rustyRaccoon/DiffProbe/README.md

# DiffProbe
 High Voltage differential probe for a scope running on 5V USB
