rustyRaccoon/DiffProbe/Simulations/DiffProbe_-20dB_bode.pdf

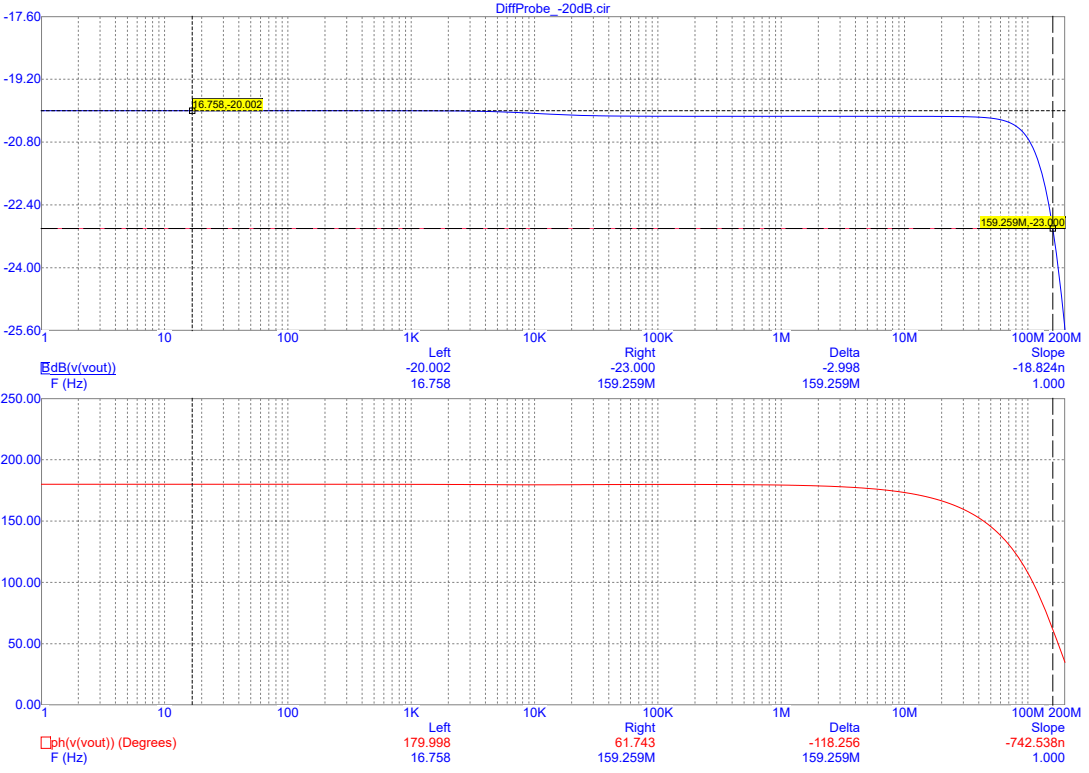
[picture p1: page 1]
BdB(v(vout)) F (Hz); DiffProbe_-20dB.cir; Left; Right; Delta; Slope

ph(v(vout)) (Degrees)
