rustyRaccoon/DiffProbe/Simulations/DiffProbe_-20dB.cir

[Main]
FileType=CIR
Version=12.00
Program=Micro-Cap
Component Version=10.00
Shape Version=11.00
Screen=3072,1728
MCAPVersion=12.2.0.5
Key ID=Demo
NLCnt=238
TXCnt=29

[shapedef]
Name=Battery
Line=0,0,22,0
Line=22,-3,22,3
Line=26,-7,26,7
Line=26,0,48,0
Current=32,8,16,8

[shapedef]
Name=Capacitor
Line=0,0,22,0
Line=22,-8,22,8
Line=26,-8,26,8
Line=26,0,48,0
Current=32,12,16,12

[shapedef]
Name=Diode
Root="Diode.root",0,0,0

[shapedef]
Name=Diode.root
Line=0,0,20,0
Line=28,0,48,0
Rectangle=18,-8,20,8
PolyClosed=3
PolyLine=20,0
PolyLine=28,-8
PolyLine=28,8
Current=32,16,16,16

[shapedef]
Name=DPMOS
Root="Mos2.root",0,0,0
Line=14,0,24,0
PolyClosed=3
PolyLine=17,-3
PolyLine=17,3
PolyLine=20,0

[shapedef]
Name=Ferrite Bead
Arc=26,-8,32,8 , 29,9,29,-10
Line=48,0,32,0
Ellipse=20,-4,23,4
FColor=None
Ellipse=18,-8,25,8
FColor=None
Line=21,-8,29,-8
Line=29,8,21,8
Line=0,0,22,0

[shapedef]
Name=Ground
Line=0,0,12,0
Line=12,-8,12,8
Line=18,-4,18,4
Line=24,0,24,0

[shapedef]
Name=Minus.root
Line=-2,0,2,0

[shapedef]
Name=Mos2.root
Line=0,8,10,8
Line=10,-8,10,8
Line=14,-11,14,-5
Line=14,-3,14,3
Line=14,5,14,11
Line=14,-8,24,-8
Line=14,8,24,8
Line=24,0,24,24
Line=24,-8,24,-24
Current=32,-24,32,-16
Current=32,24,32,16
Current=0,0,8,0

[shapedef]
Name=Opamp5
Root="Opamp.root",0,0,0
Root="Plus.root",25,-4,0
Root="Minus.root",25,52,0
Line=32,56,32,34
Line=32,-8,32,13

[shapedef]
Name=Opamp.root
Line=0,48,6,48
Line=0,0,5,0
Line=6,-4,6,52
Line=6,-4,48,24
Line=6,52,48,24
Line=48,24,72,24
Line=10,12,14,12
Line=12,10,12,14
Line=10,36,14,36
Line=4,0,6,0

[shapedef]
Name=Plus.root
Line=-2,0,2,0
Line=0,-2,0,2

[shapedef]
Name=Pot
Line=0,0,12,0
Line=12,0,14,-4
Line=14,-4,18,4
Line=18,4,22,-4
Line=22,-4,26,4
Line=26,4,30,-4
Line=30,-4,34,4
Line=34,4,36,0
Line=36,0,48,0
PolyClosed=4
PolyLine=24,4
PolyLine=24,4
PolyLine=22,8
PolyLine=26,8
Line=24,8,24,16

[shapedef]
Name=Resistor
PolyOpen=12
PolyLine=0,0
PolyLine=0,0
PolyLine=12,0
PolyLine=14,-4
PolyLine=18,4
PolyLine=22,-4
PolyLine=26,4
PolyLine=30,-4
PolyLine=34,4
PolyLine=36,0
PolyLine=48,0
PolyLine=48,0
Current=32,8,16,8

[shapedef]
Name=Sparkgap
Ellipse=0,-8,32,24
FColor=None
Line=16,-16,16,0
Line=16,16,16,32
Rectangle=8,-2,24,0
Rectangle=8,16,24,18

[shapedef]
Name=SPICE_V
Root="Vsource.root",0,0,0

[shapedef]
Name=Vsource.root
Line=0,0,12,0
Line=36,0,48,0
Ellipse=12,-12,36,12
FColor=None
Line=7,5,7,9
Root="Plus.root",41,7,0
Current=32,16,16,16

[compdef]
Name=Capacitor
Definition=Capacitor
Shape=Capacitor
Mask=7425
Used=77
memo=Capacitor
Label Offset=16,12,12,12
PinCnt=2
Pin="Plus",6,0,-3,-5
Pin="Minus",0,0,-14,-5

[compdef]
Name=Resistor
Definition=Resistor
Shape=Resistor
Mask=7937
Used=289
memo=Resistor
Label Offset=18,6,8,11
PinCnt=2
Pin="Plus",6,0,-10,-4
Pin="Minus",0,0,-14,-4

[compdef]
Name=Pot
Definition=Macro
Shape=Pot
Mask=5632
Used=7
memo=Potentiometer Macro
Label Offset=32,4,9,11
PinCnt=3
Pin="PINA",a,0,0,-13,-5
Pin="PINB",a,3,2,6,5
Pin="PINC",a,6,0,-12,-5

[compdef]
Name=Ground
Definition=Ground
Shape=Ground
Mask=257
Used=349
memo=Ground
Label Offset=0,0,0,0
PinCnt=1
Pin="PinA",0,0,-3,-7

[compdef]
Name=Voltage Source
Definition=VSpice
Shape=SPICE_V
Mask=4865
Used=48
memo=Voltage Source
Label Offset=19,13,15,13
PinCnt=2
Pin="Plus",6,0,-5,-6
Pin="Minus",0,0,-20,-6

[compdef]
Name=Battery
Definition=Battery
Shape=Battery
Mask=6913
Used=54
memo=Battery
Label Offset=19,7,10,13
PinCnt=2
Pin="Plus",6,0,-4,-5
Pin="Minus",0,0,-10,-5

[compdef]
Name=1N4148
Definition=Diode
Shape=Diode
Mask=4226
memo=Switching Diode Vr=100V If=200mA
Label Offset=18,10,12,12
PinCnt=2
Pin="Anode",6,0,-13,-8
Pin="Cathode",0,0,-27,-8

[compdef]
Name=LM7301_NS
Definition=Subckt
Shape=Opamp5
Mask=4224
memo=Low Power, 4MHz GBW, Rail-to-Rail Input-Output Opamp
Label Offset=51,34,-8,44
PinCnt=5
Pin="3",a,0,0,-3,-4
Pin="2",a,0,6,-3,18
Pin="4",a,4,-1,6,15
Pin="5",a,4,7,6,0
Pin="6",a,9,3,-3,-3

[compdef]
Name=Opamp
Definition=Opamp
Shape=Opamp5
Mask=4097
Used=4
memo=Opamp
Label Offset=44,29,-14,39
PinCnt=5
Pin="Plus input",0,0,-31,-7
Pin="Minus input",0,6,-33,20
Pin="VEE",4,7,3,-5
Pin="Output",9,3,-13,-4
Pin="VCC",4,-1,5,14

[compdef]
Name=DPMOS
Definition=PMOS
Shape=DPMOS
Mask=4096
memo=DPMOS
Label Offset=28,-11,-5,25
PinCnt=4
Pin="Drain",3,-3,8,5
Pin="Gate",0,1,-20,-3
Pin="Source",3,3,8,11
Pin="Body",3,3,8,0

[compdef]
Name=ILBB0805_320
Definition=Subckt
Shape=Ferrite Bead
Mask=4224
memo=Multilayer Ferrite Bead Z=32ohm Idc=600mA
Label Offset=21,11,9,10
PinCnt=2
Pin="1",a,0,0
Pin="2",a,6,0

[compdef]
Name=Sparkgap
Definition=Macro
Shape=Sparkgap
Mask=4096
memo=Sparkgap Macro
Link=http://www.spectrum-soft.com/news/winter99/sparkgap.shtm
Label Offset=35,-6,-14,32
PinCnt=2
Pin="Pin1",a,2,-2,5,8
Pin="Pin2",a,2,4,5,5

[Circuit]
Window Placement=2,3, -1,-1, -8,-31, 838,0,1674,842
Default Object=Color=#FF396B
Default Object Font=Height=-15,FStyle=0,Color=#000080,Name=Arial
Default Object Apply Border To Text=No
Default Object Apply Fill To Text=No
Default Object GridSnap=No
NodeVoltageFormat=3
CurrentFormat=3
PowerFormat=3
PathDelayFormat=3
WarningFormat=3
GridTextFormulaFormat=3
Window Placement in Transient Analysis=2,3, -1,-1, -8,-31, 0,242,949,655
Window Placement in AC Analysis=2,3, -1,-1, -8,-31, 0,0,949,655
Window Placement in DC Analysis=2,3, -1,-1, -8,-31, 0,0,1363,669
SpiceType=AMBIGUOUS
Title_Block_Border=None
Title_Block=False
Show Nodes=False
Show Voltages=True
Show Current=False
Show Power=False
Show Condition=False
Show Pin Connections=False
Show Connection Warnings=False
Show Cross=False
Show Attribute Text=True
Show Grid Text=True

[Object]
Object=Rectangle
CBorder=#000080
Px=1524,1386,2288,1684

[Object]
Object=Rectangle
CBorder=#000080
Px=1392,783,1917,1344

[Object]
Object=Rectangle
CBorder=#000080
Px=1964,766,2529,1286

[Comp]
Name=Capacitor
Px=1632,864
Rot=6

[Attr]
ON=-32,-40,PART
V=C1
Style=8192

[Attr]
ON=-34,-25,CAPACITANCE
V=12p
Style=8192

[Attr]
ON=0,44,MODEL
V=TOL

[Attr]
ON=0,0,PACKAGE
V

[Comp]
Name=Resistor
Px=1560,912

[Attr]
ON=18,6,PART
V=R1
Style=8192

[Attr]
ON=18,20,RESISTANCE
V=1.5Meg
Style=8192

[Attr]
ON=0,33,MODEL
V=TOL

[Attr]
ON=0,0,PACKAGE
V

[Comp]
Name=Capacitor
Px=1632,1296
Rot=2

[Attr]
ON=-33,26,PART
V=C5
Style=8192

[Attr]
ON=-36,8,CAPACITANCE
V=12p
Style=8192

[Attr]
ON=0,44,MODEL
V=TOL

[Attr]
ON=0,0,PACKAGE
V

[Comp]
Name=Resistor
Px=1560,1248
Rot=4

[Attr]
ON=18,-20,PART
V=R5
Style=8192

[Attr]
ON=18,-34,RESISTANCE
V=1.5Meg
Style=8192

[Attr]
ON=0,33,MODEL
V=TOL

[Attr]
ON=0,0,PACKAGE
V

[Comp]
Name=Resistor
Px=1632,960
Rot=1

[Attr]
ON=8,11,PART
V=R9
Style=8192

[Attr]
ON=8,25,RESISTANCE
V=100k
Style=8192

[Attr]
ON=0,33,MODEL
V=TOL

[Attr]
ON=0,0,PACKAGE
V

[Attr]
ON=0,11,COMBINATION
V=35.7K

[Comp]
Name=Resistor
Px=1632,1008
Rot=1

[Attr]
ON=8,11,PART
V=R10
Style=8192

[Attr]
ON=8,25,RESISTANCE
V=1k
Style=8192

[Attr]
ON=0,33,MODEL
V=TOL

[Attr]
ON=0,0,PACKAGE
V

[Attr]
ON=0,11,COMBINATION
V=3.01K

[Comp]
Name=Resistor
Px=1632,1200
Rot=5

[Attr]
ON=8,-25,PART
V=R11
Style=8192

[Attr]
ON=8,-39,RESISTANCE
V=100k
Style=8192

[Attr]
ON=0,33,MODEL
V=TOL

[Attr]
ON=0,0,PACKAGE
V

[Attr]
ON=0,11,COMBINATION
V=35.7K

[Comp]
Name=Resistor
Px=1632,1152
Rot=5

[Attr]
ON=8,-25,PART
V=R12
Style=8192

[Attr]
ON=8,-39,RESISTANCE
V=1k
Style=8192

[Attr]
ON=0,33,MODEL
V=TOL

[Attr]
ON=0,0,PACKAGE
V

[Attr]
ON=0,11,COMBINATION
V=3.01K

[Comp]
Name=Pot
Px=1632,1104
Rot=3

[Attr]
ON=-25,-25,PART
V=X1
Style=8192

[Attr]
ON=-30,-39,FILE
V=Pot

[Attr]
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
CurrentSection 3=0
Splitter.xs=0
Splitter.ys=0
TextQuad=4099
Scale=1
GridType=GraphPaper
GridUser=10
ShapeGroups="Main","Euro","Polarity","Main1","Main11","Electrolytic","GroundArrow","DeMorgan"
CalcRMS=False
CalcAVG=False
CalcPeak=False
CalcVoltage=True
DisplayMeasure=Last
ShareScales=True
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
