rustyRaccoon/DiffProbe/DiffProbe.kicad_pcb

## KiCad design DiffProbe.kicad_pcb (2023-03-25)

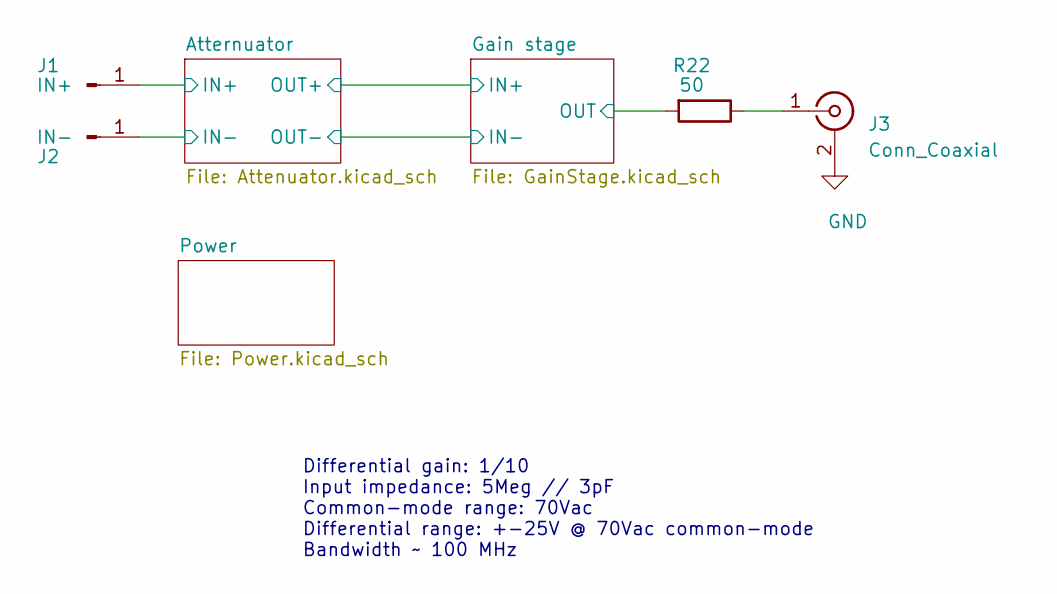
[picture p2: schematic DiffProbe.kicad_sch]

Parts:
J1: IN+; PinHeader_1x01_P2.54mm_Horizontal
J2: IN-; PinHeader_1x01_P2.54mm_Horizontal
J3: Conn_Coaxial; SMA_Samtec_SMA-J-P-X-ST-EM1_EdgeMount
R22: 50; R_0603_1608Metric

Connections:
/Atternuator/IN+: J1.1; also elsewhere on the board
/Atternuator/IN-: J2.1; also elsewhere on the board
/Gain stage/OUT: R22.2; also elsewhere on the board
GND: J3.2 (Ext); also elsewhere on the board
unnamed: J3.1 (In), R22.1

Notes on the sheet:
Differential gain: 1/10 Input impedance: 5Meg // 3pF Common-mode range: 70Vac Differential range: +-25V @ 70Vac common-mode Bandwidth ~ 100 MHz

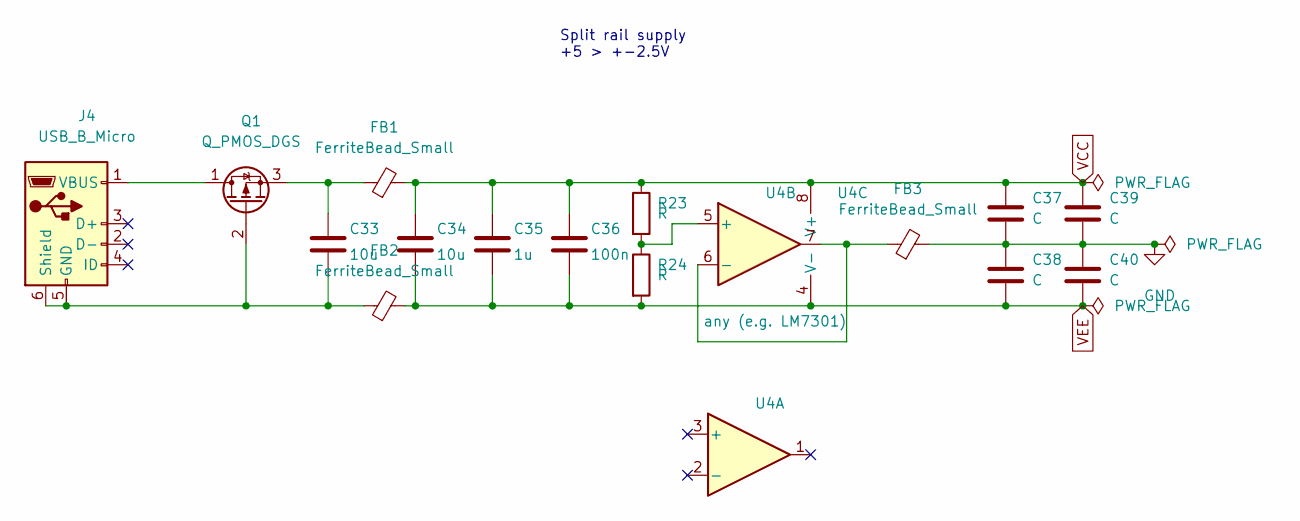
[picture p3: schematic Power.kicad_sch]

Parts:
C33, C34: 10u; C_0603_1608Metric
C35: 1u; C_0603_1608Metric
C36: 100n; C_0603_1608Metric
C37, C38, C39, C40: C; C_0603_1608Metric
FB1, FB2, FB3: FerriteBead_Small; L_0603_1608Metric
J4: USB_B_Micro; USB_Micro-AB_Molex_47590-0001
Q1: Q_PMOS_DGS; TSOT-23
R23, R24: R; R_0603_1608Metric
U4: any (e.g. LM7301); MSOP-8_3x3mm_P0.65mm

Connections:
GND: C37.2, C38.1, C39.2, C40.1, FB3.2; also elsewhere on the board
unnamed: C33.2, FB2.1, J4.5 (GND), J4.6 (Shield), Q1.2 (G)
unnamed: J4.1 (VBUS), Q1.1 (D)
unnamed: C33.1, FB1.1, Q1.3 (S)
unnamed: R23.2, R24.1, U4.5 (+)
unnamed: FB3.1, U4.6 (-), U4.7
VCC: C34.1, C35.1, C36.1, C37.1, C39.1, FB1.2, R23.1, U4.8 (V+); also elsewhere on the board
VEE: C34.2, C35.2, C36.2, C38.2, C40.2, FB2.2, R24.2, U4.4 (V-); also elsewhere on the board

Notes on the sheet:
Split rail supply +5 > +-2.5V

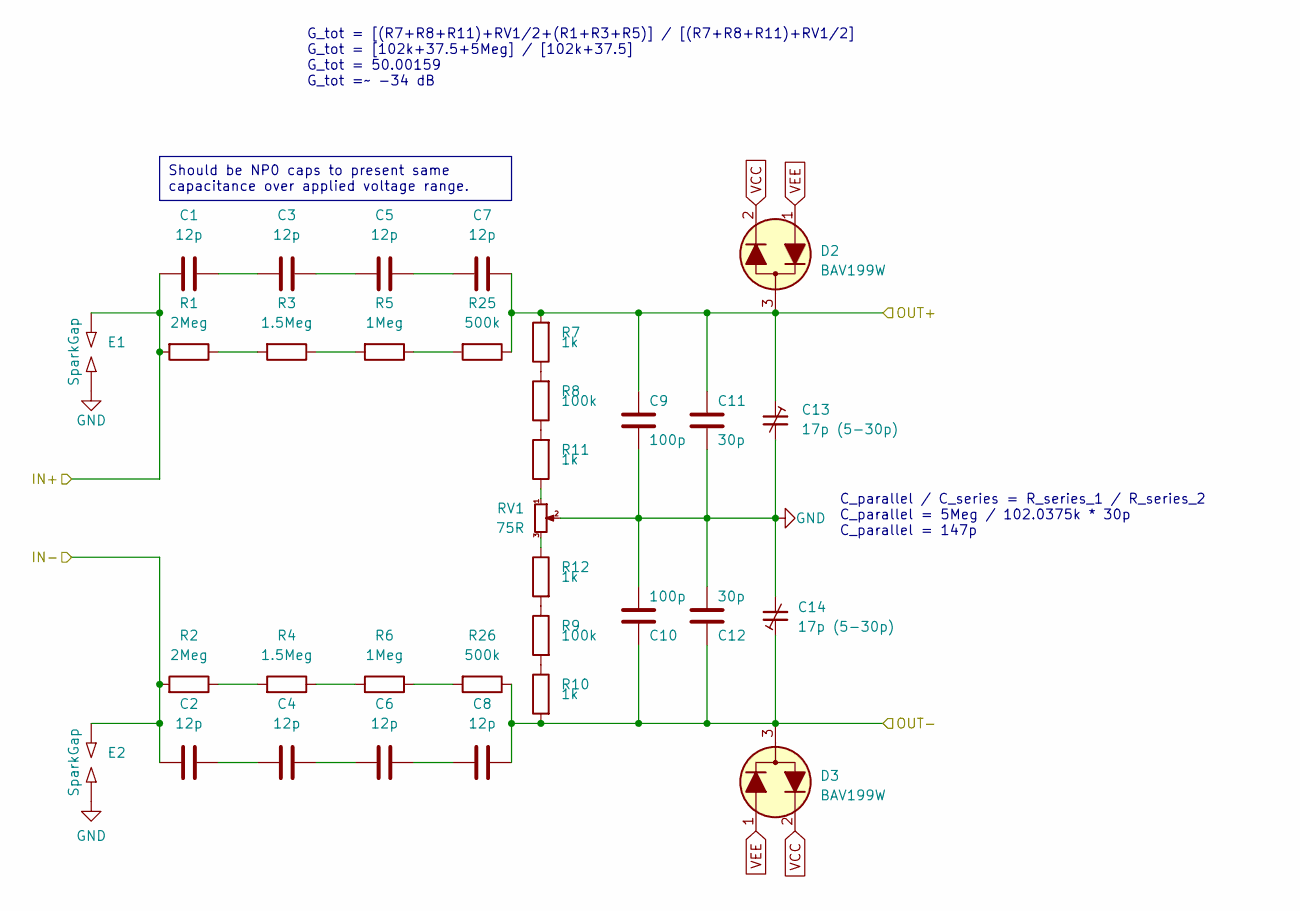
[picture p4: schematic Attenuator.kicad_sch]

Parts:
C1, C2, C3, C4, C5, C6, C7, C8: 12p; C_0603_1608Metric
C9, C10: 100p; C_0603_1608Metric
C11, C12: 30p; C_0603_1608Metric
C13, C14: 17p (5-30p); C_Trimmer_Murata_TZB4-A
D2, D3: BAV199W; SC-70
E1, E2: SparkGap; Spark_Gap_1.65x1.1
R1, R2: 2Meg; R_0603_1608Metric
R3, R4: 1.5Meg; R_0603_1608Metric
R5, R6: 1Meg; R_0603_1608Metric
R7, R10, R11, R12: 1k; R_0603_1608Metric
R8, R9: 100k; R_0603_1608Metric
R25, R26: 500k; R_0603_1608Metric
RV1: 75R; Potentiometer_Bourns_3214W_Vertical

Connections:
/Atternuator/IN+: C1.2, E1.1, R1.2; also elsewhere on the board
/Atternuator/IN-: C2.2, E2.1, R2.2; also elsewhere on the board
/Atternuator/OUT+: C7.1, C9.1, C11.1, C13.1, D2.3 (C), R7.2, R25.1; also elsewhere on the board
/Atternuator/OUT-: C8.1, C10.1, C12.1, C14.1, D3.3 (C), R10.2, R26.1; also elsewhere on the board
GND: C9.2, C10.2, C11.2, C12.2, C13.2, C14.2, E1.2, E2.2, RV1.2; also elsewhere on the board
unnamed: C1.1, C3.2
unnamed: C2.1, C4.2
unnamed: C3.1, C5.2
unnamed: C4.1, C6.2
unnamed: C5.1, C7.2
unnamed: C6.1, C8.2
unnamed: R1.1, R3.2
unnamed: R2.1, R4.2
unnamed: R3.1, R5.2
unnamed: R4.1, R6.2
unnamed: R7.1, R8.2
unnamed: R9.2, R10.1
unnamed: R11.1, RV1.1
unnamed: R8.1, R11.2
unnamed: R12.1, RV1.3
unnamed: R9.1, R12.2
unnamed: R5.1, R25.2
unnamed: R6.1, R26.2
VCC: D2.2 (K), D3.2 (K); also elsewhere on the board
VEE: D2.1 (A), D3.1 (A); also elsewhere on the board

Notes on the sheet:
Should be NP0 caps to present same capacitance over applied voltage range.
C_parallel / C_series = R_series_1 / R_series_2 C_parallel = 5Meg / 102.0375k * 30p C_parallel = 147p
G_tot = [(R7+R8+R11)+RV1/2+(R1+R3+R5)] / [(R7+R8+R11)+RV1/2] G_tot = [102k+37.5+5Meg] / [102k+37.5] G_tot = 50.00159 G_tot =~ -34 dB

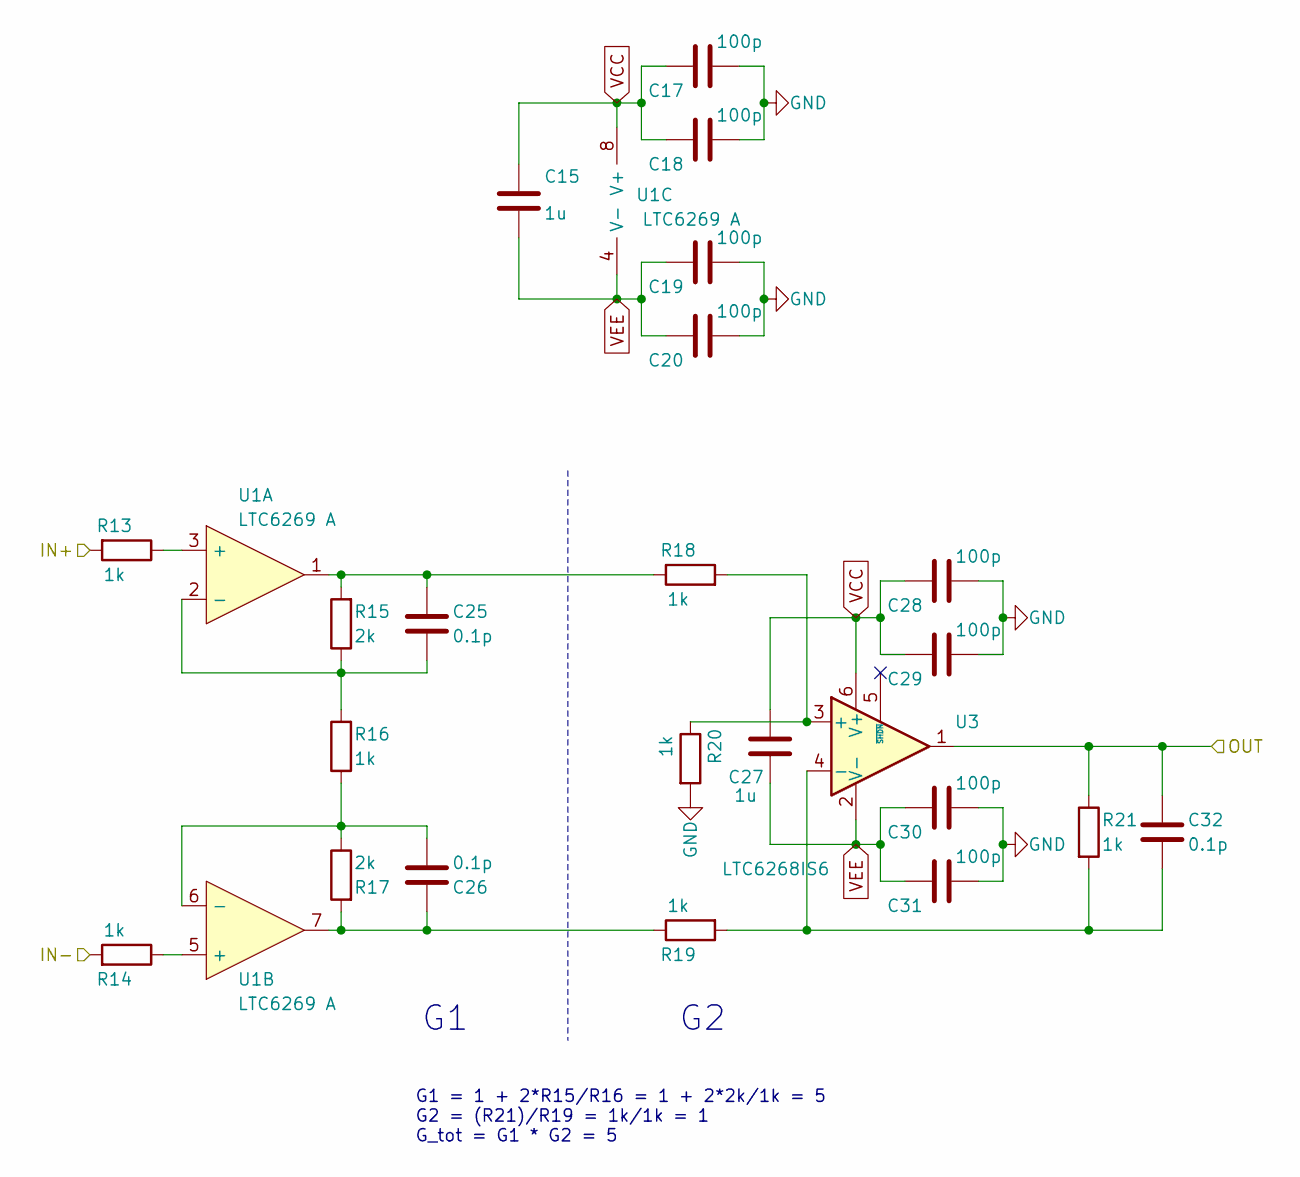
[picture p5: schematic GainStage.kicad_sch]

Parts:
C15, C27: 1u; C_0603_1608Metric
C17, C18, C19, C20, C28, C29, C30, C31: 100p; C_0603_1608Metric
C25, C26, C32: 0.1p; C_0603_1608Metric
R13, R14, R16, R18, R19, R20, R21: 1k; R_0603_1608Metric
R15, R17: 2k; R_0603_1608Metric
U1: LTC6269 A; MSOP-8-1EP_3x3mm_P0.65mm_EP1.68x1.88mm
U3: LTC6268IS6; TSOT-23-6

Connections:
/Atternuator/OUT+: R13.2; also elsewhere on the board
/Atternuator/OUT-: R14.2; also elsewhere on the board
/Gain stage/OUT: C32.2, R21.1, U3.1; also elsewhere on the board
GND: C17.1, C18.1, C19.1, C20.1, C28.1, C29.1, C30.1, C31.1, R20.2; also elsewhere on the board
unnamed: C25.1, R15.2, R18.1, U1.1
unnamed: C26.1, R17.2, R19.1, U1.7
unnamed: R13.1, U1.3 (+)
unnamed: C25.2, R15.1, R16.2, U1.2 (-)
unnamed: R14.1, U1.5 (+)
unnamed: C26.2, R16.1, R17.1, U1.6 (-)
unnamed: R18.2, R20.1, U3.3 (+)
unnamed: C32.1, R19.2, R21.2, U3.4 (-)
VCC: C15.1, C17.2, C18.2, C27.1, C28.2, C29.2, U1.8 (V+), U3.6 (V+); also elsewhere on the board
VEE: C15.2, C19.2, C20.2, C27.2, C30.2, C31.2, U1.4 (V-), U1.9 (V-), U3.2 (V-); also elsewhere on the board

Notes on the sheet:
G1 = 1 + 2*R15/R16 = 1 + 2*2k/1k = 5 G2 = (R21)/R19 = 1k/1k = 1 G_tot = G1 * G2 = 5

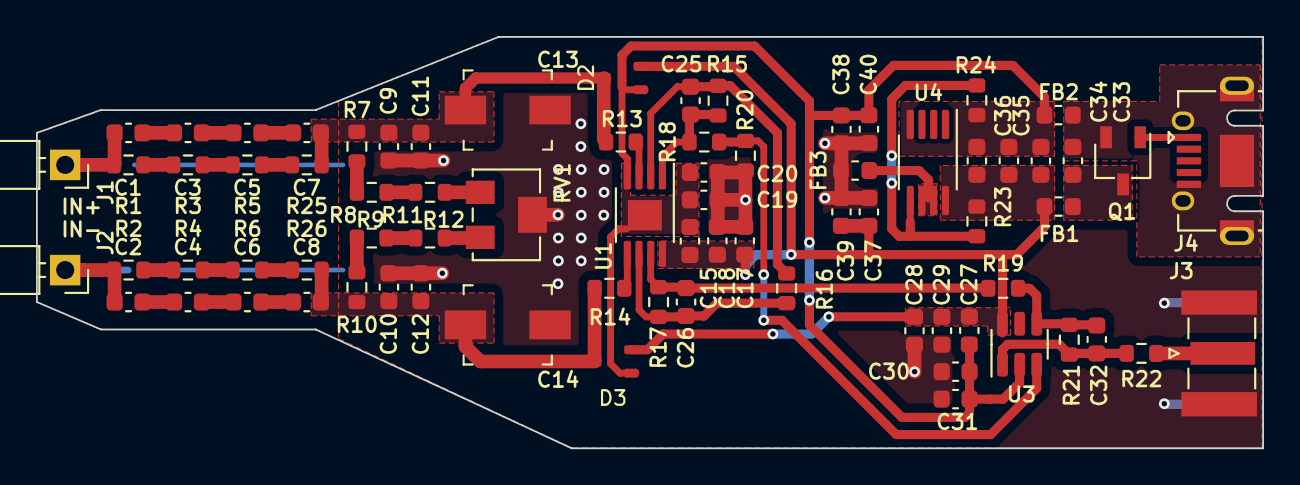
[picture p6: board DiffProbe.kicad_pcb from above]

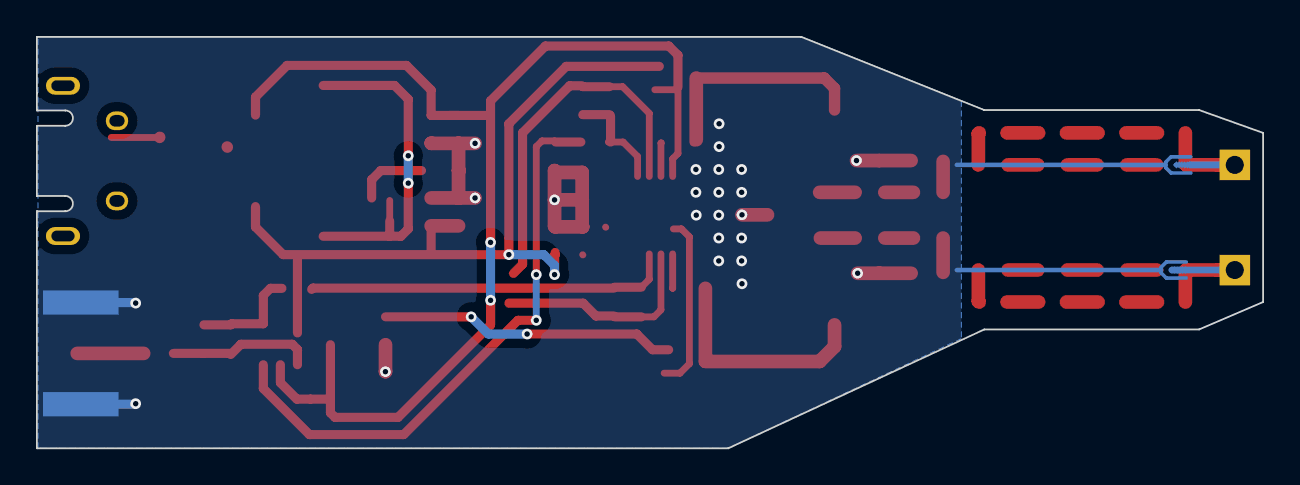
[picture p7: board DiffProbe.kicad_pcb from below]

Board: 2 copper layers, 68.1 x 22.9 mm, 77 parts (2 on the bottom side), 40 nets.
